phillipjohnston/lymph-flow-control/Docs/LymphaticVesselTesterDaughterBoard_BOM.xlsx

Lymphatic Vessel Tester Daughter Board |  |  |  |  | Est. Cost per Board:
Bill of Materials
Created by: Phillip Johnston
Mfn. Part Num | Part Name | Board Ref. Des. | Part Type | Source | Est. price/per | Quantity per board | Qty in Stock | Notes
VAT1-SMT-D12 / VAT1-SMT-D15 | Converter, DC/DC +-12V | U7 | IC |  |  | 1 | 2 | On Order! We have one 12V, and one 15V. On
AD5752 | DAC | U5 | IC |  |  | 1 | 1
REF192 |  | U6 | IC |  |  | 1 | 0 | On Order
24LC62 |  | U8 | IC |  |  | 1 | 0
 | Connector | J1, J2, J7 | CONN |  |  | 3 | 0
PCA9546AD |  | U1 | IC |  |  | 1 | 0
BC337G | Trans NPN 800MA 45V TO92 | Q1 | Transistor |  |  | 1 | 4
ERJ-8GEYJ103V | 10k Resistor, 1/4W, 5%, 1206 SMD | R1, R2, R3, R4, R5, R6, R7, | Resistor |  |  | 9 | 11
 | .1uF Cap | C1, C2, C3, C9, C10, C12, C14, C16, C18 | Capacitor |  |  | 9 | 0 | On Order
ERJ-8GEYJ202V | 2k Resistor, 1/4W 5% 1206 SMD | R8 | Resistor |  |  | 1 | 4
CX240D5 | Relay, 5A 20V | RLY0 | IC |  |  | 1 | 3
C3216X5R1A106K | 10uF Cap, 10V, 10%, 1206 SMD | C11, C13, C15, C17, | Capacitor |  |  | 4 | 10
Schematic Set #2
Mfn. Part Num | Part Name | Board Ref. Des. | Part Type | Source | Est. price/per | Quantity per board | Qty in Stock | Notes
ECS-400-20-Ex-EN-TR | 40MHz Crystal 20PF SMD | X1, X2 | Oscillator |  |  | 2 | 1
MAX3098EBCSE+ | IC , 16-pin SOIC | U1, U2 | IC |  |  | 2 | 1
LS7366R | Quadrature Decoder | U3, U4 | IC |  |  | 2 | 1
ERJ-8GEYJ105V | 1M Res, 1/4W, 5%, 1016 SMD | R7, R8 | Resistor |  |  | 2 | 6
 | 10k Res | R9, R10 | Resistor |  |  | 2 | 11
GCM31A7U2J150Jx01D | 15pF Cap, 630V, 5%, 1206 | C1, C2, C3, C4 | Capacitor |  |  | 4 | 11
 | 120 Res | R1, R2, R3, R4, R5, R6 | Resistor |  |  | 6 | 0 | On Order
 | .1uF Cap | C5, C6, C7, C8 | Capacitor |  |  | 4 | 0
 | 6-pin Conn | J5, J6 | CONN |  |  |  | 0
 | 8-pin CONN | J3, J4 | CONN |  |  |  | 0
