phillipjohnston/lymph-flow-control/Docs/Schematics/daughter_board_sch-1.pdf

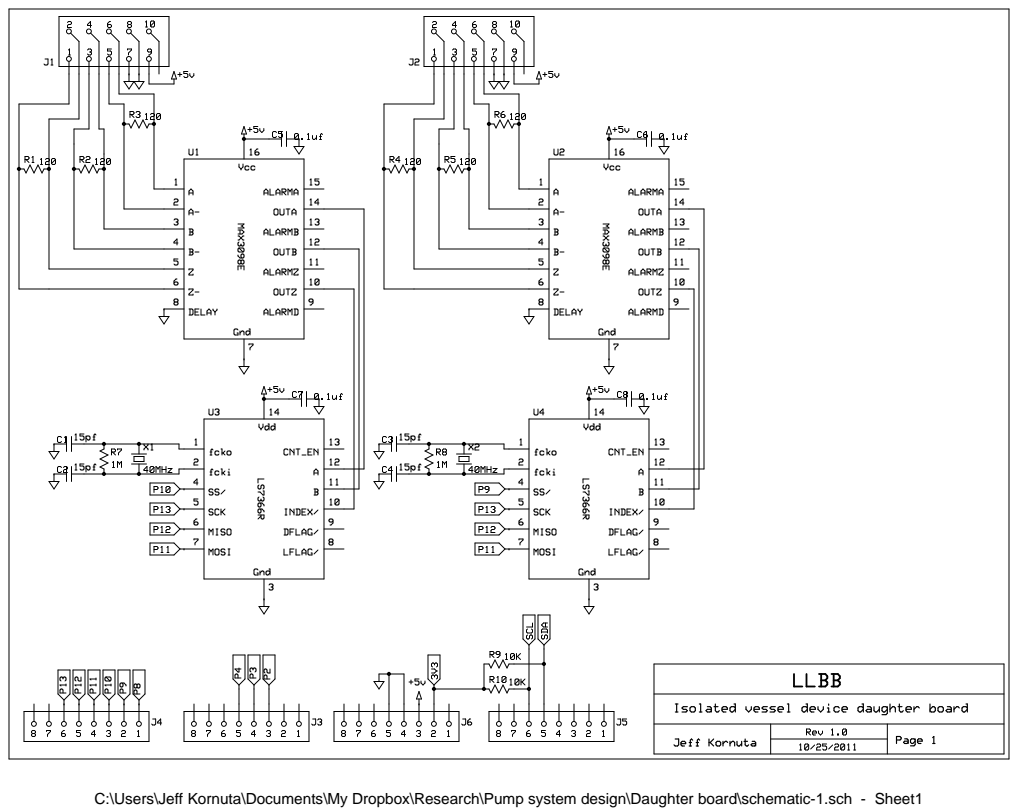
[picture p6: page 1]

C:\Users\Jeff Kornuta\Documents\My Dropbox\Research\Pump system design\Daughter board\schematic-1.sch - Sheet1
