phillipjohnston/lymph-flow-control/Docs/Schematics/vix_interface_sch.pdf

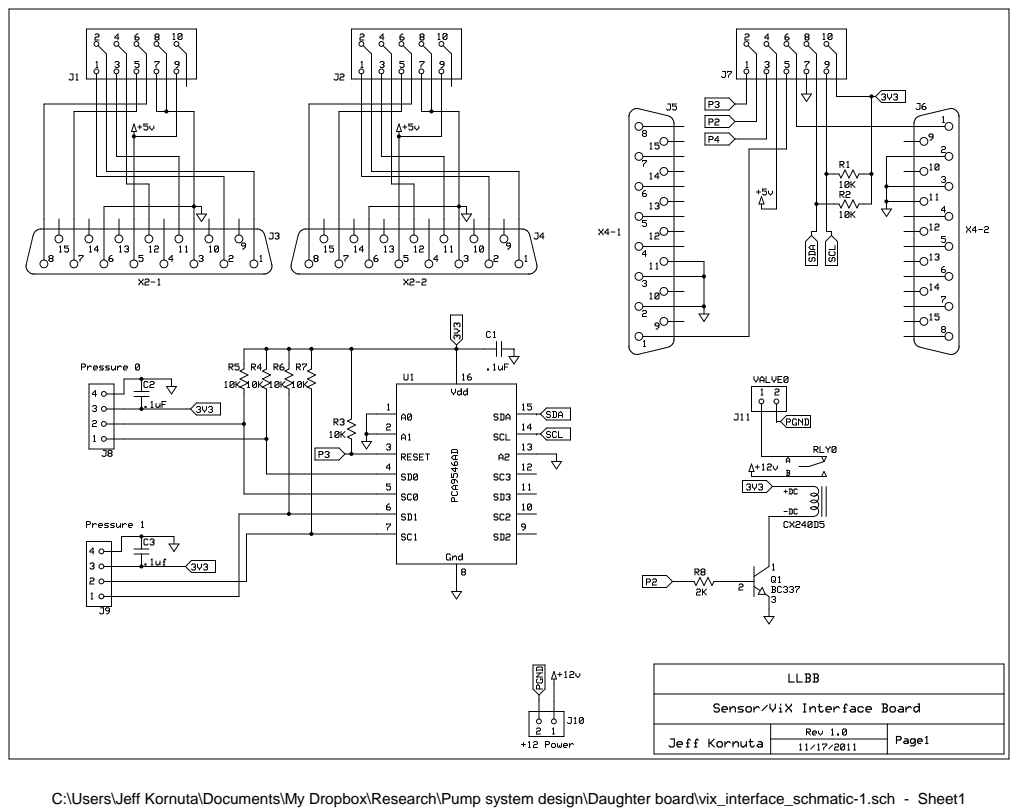
[picture p7: page 1]

C:\Users\Jeff Kornuta\Documents\My Dropbox\Research\Pump system design\Daughter board\vix_interface_schmatic-1.sch - Sheet1
