phillipjohnston/lymph-flow-control/(commit log)

2012-05-23 Initial addition of DAC class in Servo.cpp. Have not tested to see if code compiles.
2012-05-23 Added folder structure to contain documentation related to the project. Initial checkin contains PIC32 Uno32 board reference manual and DAC 5752 datasheet.
2012-05-23 Added lymph-flow-control.pde to satisfy the Arduino IDE. Used for testing purposes at the moment.
2012-05-23 Fixed register mapping definition for the DAC library. Created a testers folder and put the DAC test code there.
    [DACTester.pde, Servo.cpp, Servo.h, dac5752.cpp, dac5752.h]
2012-05-23 Removed print statements which printed the values for the DAC register mapping.
2012-05-25 Added function prototype for a power down sequence for the DAC. Also changed the names of the PUA/PUB/POWER_UP_ALL and ADDRESS_A/B/ALL definitions in order to make them more sensible for use in the m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
2012-05-25 Added skeleton of function to power down dacs. commented out for later implementation.
2012-05-25 Powering on both DACs and verifying output of each is close to 5V.
2012-05-25 Created ServoTester MPIDE project
2012-05-31 Finished conversion from original jumbled Servo code to using DAC and Quadrature Decoder classes and calls.
2012-05-31 Added more documentation. Daughter board schematic.
2012-06-04 Whitespace cleanup for Servo class
2012-06-04 Initial creation of BOM for daughter board
    [LymphaticVesselTesterDaughterBoard_BOM.xlsx]
2012-06-04 Whitespace cleanup on files in Devices
2012-06-05 Updated inventory
    [LymphaticVesselTesterDaughterBoard_BOM.xlsx]
2012-06-08 Changed DAC to operate at +-10V
2012-06-08 Added definition for Servo::Move()
2012-06-11 Uploaded library for reading pressure from the Honeywell HSC digital (I2C) sensor, as well as the PCA9546A I2C multiplexer
2012-07-05 Added additional functionality to DAC library that allows control of the SDO line (enable/disable). Added datasheet. Minor modifications to Servo library to utilize the DAC changes.
2012-08-16 Modified servo class to accept a DAC as an input, allowing two servo objects to control a separate DAC.
2012-08-16 Updated DAC tester to use most recent library version. Reworked tester for 12V bipolar tests.
    [DACTester.pde, SPIDevice.cpp, dac5752.cpp, dac5752.h]
2012-08-16 Removed comment in default constructor that was preventing the Quadrature Decoder from working correctly.
    [SPIDevice.cpp, SPIDevice.h]
2012-08-16 Updated the servo library used by the tester to match the new library version
2012-08-16 Modified the Servo object to include a dac as the input. Initial (bugged) version of system identification code.
    [systemIdentification.pde]
